mzvic/Piezopulse/20250524PruebaSchussler/Spectacular Allis.stl

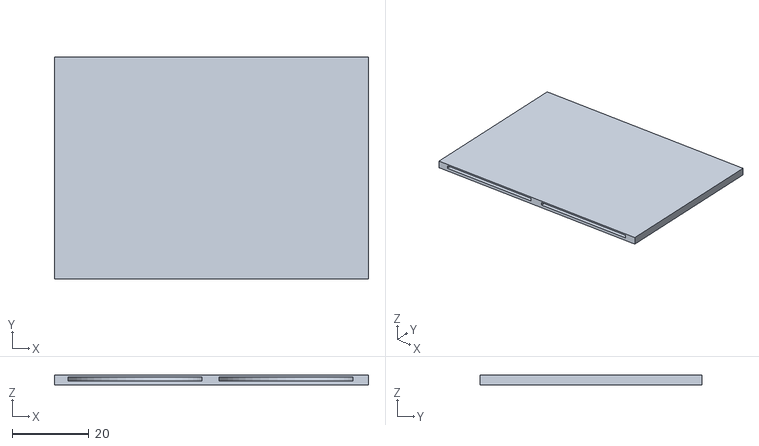
[picture p1: CAD file, 2025-06-02]
20250524PruebaSchussler/Spectacular Allis.stl
82.0 x 58.0 x 2.50
