mzvic/Piezopulse/20250608PruebaBasquetUdec/carcasa.stl

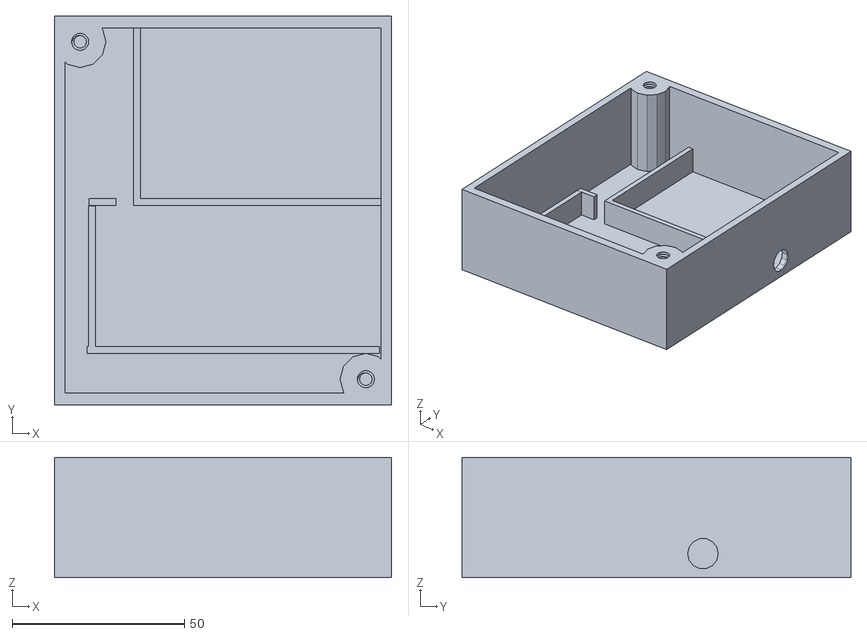
[picture p2: CAD file, 2025-06-09]
20250608PruebaBasquetUdec/carcasa.stl
98.0 x 113.0 x 35.0
