mzvic/Piezopulse/20250524PruebaSchussler/tex/main.pdf

# Reporte Pruebas Piezopulse en Schussler S.A. 24/05

Isabel Fuentes
Vicente Montesinos

19 de junio de 2025

## Índice

1. Contextualización | 2
2. Configuración Experimental | 3
3. Resultados y Análisis | 5
4. Conclusión y próximos pasos | 8

## 1. Contextualización

Piezopulse es un proyecto innovador que busca aprovechar las vibraciones mecánicas generadas por maquinaria industrial y transformarlas en energía eléctrica almacenable. Mediante tecnología de piezoelectricidad, estas vibraciones se convierten en electricidad, la cual se almacena en baterías para su posterior uso. De esta manera, las empresas pueden optimizar su consumo energético, reducir costos y promover prácticas más sostenibles al reutilizar energía que normalmente se perdería.
Actualmente, se encuentra en la fase de evaluación de sistemas de captación, con el objetivo de maximizar la eficiencia de conversión y minimizar las pérdidas.
Como parte de esta fase, se realizaron pruebas en Schussler S.A., enfocadas en un equipo de su operación: una impresora flexográfica, específicamente en la sección de ventiladores. Se seleccionó esta máquina debido que es la que está constantemente en funcionamiento sin interrupciones. Para caracterizar el comportamiento mecánico del sistema, se midieron las vibraciones de la máquina utilizando un acelerómetro, lo que permitió cuantificar la amplitud y frecuencia de las oscilaciones. En paralelo, se registró el voltaje generado por los elementos piezoeléctricos bajo estas condiciones operativas, estableciendo una relación directa entre el movimiento mecánico y la energía eléctrica recuperable.


Figura 1: Sistema puesto en terreno

## 2. Configuración Experimental

El prototipo desarrollado para las pruebas en Schussler S.A. incorporó los siguientes componentes clave, configurados de la siguiente manera:

### 2.1. Captación de Energía

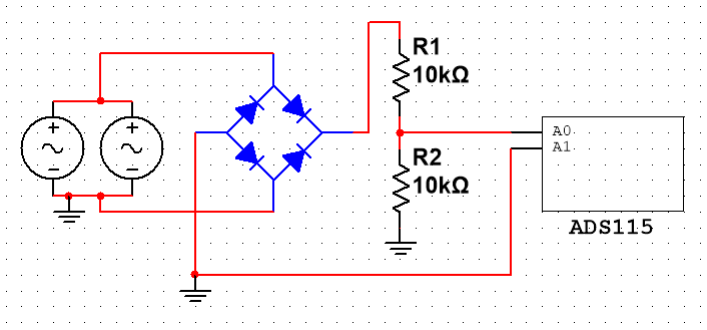
[picture p10: figure]

Figura 2: Esquema del sistema piezoeléctrico (Representados con una fuente alterna)

El sistema de captación de energía consiste en dos elementos piezoeléctricos de 35mm conectados en paralelo, una disposición que permite maximizar la corriente de salida en respuesta a las vibraciones mecánicas. La señal alterna generada por los piezos se convierte a corriente continua mediante un puente rectificador Schottky, seleccionado específicamente para minimizar las pérdidas por caída de voltaje en el proceso de rectificación. Para garantizar la seguridad del sistema de medición, se implementó un divisor resistivo de 10kΩ que asegura que el voltaje no exceda los 5V, límite máximo de entrada del conversor analógico-digital ADS1115, protegiendo así el circuito de adquisición de datos contra posibles picos de voltaje.

Con diodos estándar (1N4007): VF ≈ 0,7V ⇒ Vpérdida = 1,4V Con Schottky (1N5817): VF ≈ 0,3V ⇒ Vpérdida = 0,6V

Donde VF es la caída de voltaje directo en cada diodo.

Para la correcta integración de la captación de energía, se desarrolló un modelo 3D para alojar los dos piezoeléctricos. Este diseño comprende dos capas de material: una primera capa de 0.5 mm de espesor diseñada para estar en contacto directo con la máquina, facilitando la transferencia de vibraciones. Superpuesta a esta, se encuentra una segunda capa de 1 mm de espesor. En el interior de estas capas, se incorporó un hueco de 1 mm de profundidad diseñado con precisión para permitir la ubicación óptima de los piezoeléctricos de 35 mm de diámetro, asegurando su estabilidad y el correcto acoplamiento mecánico para una eficiente recolección de energía.


Figura 3: Modelo con piezoeléctrico

### 2.2. Medición y Adquisición de Datos

El sistema incorpora un acelerómetro MPU6050 que registra con precisión las vibraciones de la impresora flexográfica a lo largo de los tres ejes espaciales (X, Y y Z). Complementando este subsensor, se emplea un convertidor analógico-digital ADS1115 configurado en modo diferencial, donde la entrada positiva (A0) recibe la señal de los piezos rectificados y la entrada negativa (A1) se conecta a tierra como referencia, ofreciendo una lectura precisa del voltaje rectificado proveniente de los elementos piezoeléctricos con una resolución de 16 bits para las mediciones eléctricas. Esta configuración diferencial permite eliminar el ruido común y mejorar la precisión de las mediciones en el entorno industrial. Un microcontrolador Arduino Uno centraliza el procesamiento, recibiendo y almacenando los datos provenientes tanto del MPU6050 como del ADS1115.

### 2.3. Procesamiento y Almacenamiento

El subsistema de procesamiento y almacenamiento, implementado mediante un código Arduino[1], opera en tiempo real registrando simultáneamente los datos de vibración captados por el acelerómetro MPU6050 y las mediciones de voltaje obtenidas del circuito piezoeléctrico a través del ADC ADS1115.

Figura 4: Sistema General

## 3. Resultados y Análisis

### 3.1. Caracterización de la Vibración

### 3.1.1. Estadística generales por eje

El acelerómetro tri-axial (MPU6050) instalado en la impresora flexográfica proporcionó información en las componentes AccelX, AccelY y AccelZ, en unidades de m/s²
:
| Mínimo | Máximo | Media | Desviación Estándar
AccelX | -10.52 | -8.18 | -9.36 | 0.325
AccelY | -2.38 | 3.77 | 0.642 | 0.187
AccelZ | -3.03 | 0.280 | -1.41 | 0.385

Eje X (AccelX): La media cercana a -9.8 m/s² indica que este eje está alineado con la dirección de la gravedad. La desviación estándar baja (0.32 m/s²
| | | | ) sugiere que las vibraciones en este eje
son mínimas o casi inexistentes. La máquina permanece estable en este eje.

Eje Y (AccelY): La aceleración promedio es de 0.64 m/s²
| | | | , con una desviación moderada (0.19
m/s²

), lo que indica presencia de vibración ligera. El rango desde -2.38 a 3.77 m/s² muestra que existen picos en ambos sentidos, lo que sugiere oscilaciones transversales posiblemente inducidas por el funcionamiento de la máquina.

Eje Z (AccelZ): Este eje muestra una aceleración promedio negativa (-1.41 m/s²
) con la mayor
desviación estándar de los tres (0.38 m/s²

), y un rango significativo (-3.03 a 0.28 m/s² ). Esto
indica que el eje Z es el más afectado por las vibraciones de la máquina, probablemente en la dirección vertical u otra perpendicular al plano principal del equipo.

En resumen, el eje más vibrante es el Z, seguido del Y, mientras que el X está dominado por la gravedad (poca vibración útil).

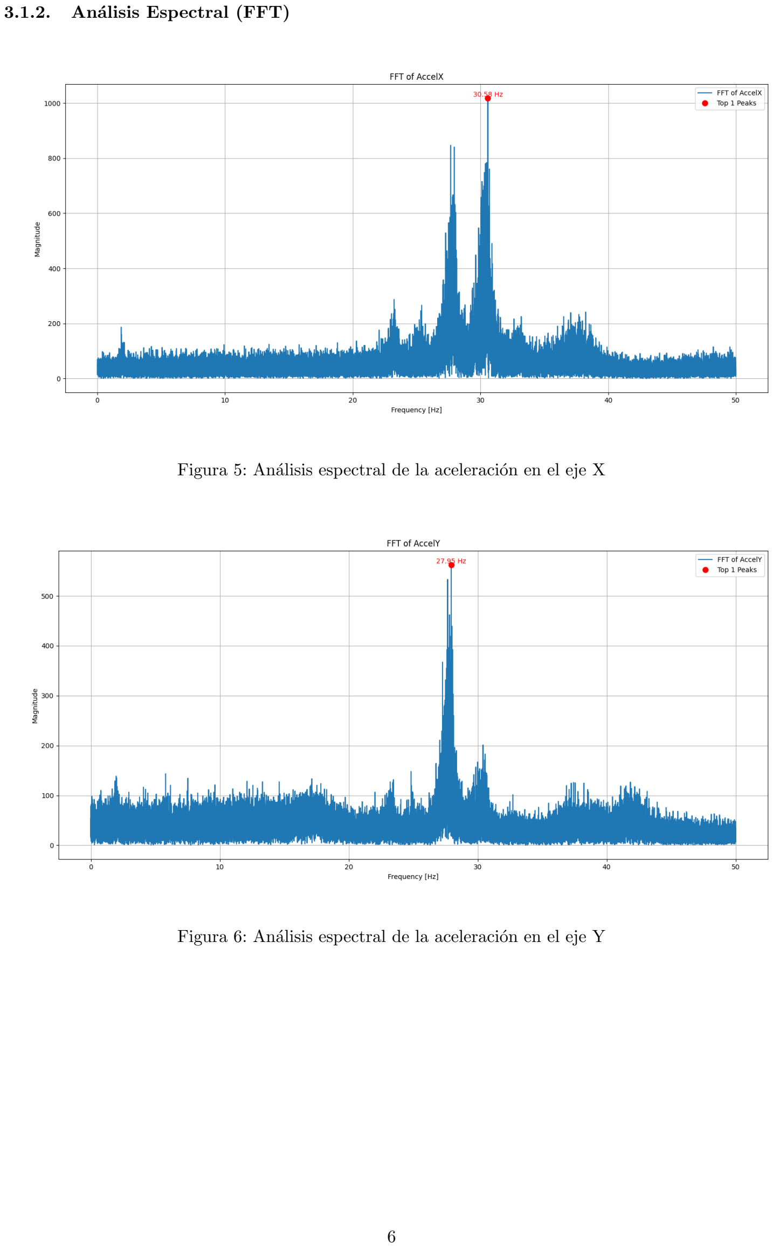
[picture p11: page 6]

### 3.1.2. Análisis Espectral (FFT)

Figura 5: Análisis espectral de la aceleración en el eje X

Figura 6: Análisis espectral de la aceleración en el eje Y


Figura 7: Análisis espectral de la aceleración en el eje Z

Se aplicó una transformada rápida de Fourier (FFT) a las señales de aceleración en los tres ejes (AccelX, AccelY, AccelZ) para identificar las componentes de frecuencia presentes durante el funcionamiento de la impresora flexográfica. Se observó un pico dominante de amplitud en torno a los 30 Hz en los tres ejes. Esta frecuencia es relevante para el proyecto, ya que si el sistema piezoeléctrico tiene una frecuencia de resonancia cercana a 30 Hz, se maximiza la eficiencia de conversión energética.

### 3.2. Energía piezoeléctrica

Durante la operación de la máquina, se registró el voltaje generado por un conjunto de piezoeléctricos conectados en paralelo, acoplados mecánicamente a su estructura. La señal fue rectificada y atenuada mediante una divisora resistiva (2 resistencias de 10kΩ) antes de ser medida por un conversor ADS1115 en modo diferencial.

| Mínimo | Máximo | Media | Desviación Estándar
Voltaje | 0.00 | 10.10 | 0.664 | 0.653

Cuadro 1: Estadísticas del voltaje producido por los piezoeléctricos (en milivolts)

Aunque los niveles de voltaje son bajos, se confirma que los piezoeléctricos generan señal eléctrica a partir de las vibraciones reales de la máquina. La aparición de voltajes máximos cercanos a 10mV demuestra que en ciertas condiciones, posiblemente a picos de vibración, el sistema puede captar energía de forma significativa. La media baja indica que el sistema no opera continuamente en esas condiciones óptimas, lo que es esperable dado que el acoplamiento no está sintonizado aún para 30 Hz.
En conclusión, el sistema es capaz de convertir vibraciones mecánicas reales en energía eléctrica, incluso en condiciones no óptimas y la señal generada puede ser utilizada como fuente de energía si se incorpora un sistema de acumulación y regulación.

### 3.3. Relación entre vibración y generación

Ya que se observó que el eje más vibrante es el Z, haremos la comparación entre el voltaje generado por los piezoeléctricos y la vibración en el eje Z.


Figura 8: Extracto de las muestras obtenidas.

Se encontraron 13331 puntos donde ambos valores aumentan al mismo tiempo, estos puntos se muestran reflejados en verde en el gráfico. Se evidencian coincidencias temporales entre los picos de aceleración y los aumentos de voltaje. Esto confirma que el sistema piezoeléctrico responde de forma efectiva a la vibración mecánica, transformando parte de la energía cinética en voltaje utilizable.

## 4. Conclusión y próximos pasos

La prueba realizada sobre una impresora flexográfica permitió validar el concepto fundamental del sistema PiezoPulse: convertir vibraciones mecánicas reales en energía eléctrica utilizable mediante piezoeléctricos. Los principales hallazgos son:

Se observó una frecuencia dominante de vibración en 30 Hz, presente en los tres ejes del acelerómetro, lo que indica una oscilación estructural importante en la máquina.

El eje Z mostró la mayor variabilidad, coincidiendo con la mayor actividad vibracional y con los momentos de mayor voltaje generado por los piezoeléctricos.

El voltaje piezoeléctrico alcanzó valores de hasta 10.1mV, con una media de 0.66mV, demostrando la capacidad del sistema para captar energía real desde el entorno.

En conjunto, los resultados respaldan la viabilidad del enfoque PiezoPulse y permiten avanzar hacia una implementación práctica.
Para escalar y mejorar el sistema, se proponen las siguientes acciones:

Probar con diferentes conexiones de piezoeléctricos (paralelo o serie) y escalar el número de piezoeléctricos ocupados

Utilizar piezoeléctricos con una frecuencia de resonancia más cercana a los 30 Hz observados o evaluar otras estructuras mecánicas resonantes.

Integrar un sistema con diodos Schottky + supercondensador o batería Li-ion para acumular la energía generada.

## Referencias

[1] A. M. Z. Vicente, “Piezopulse Data,” GitHub repository, 2025. [Online]. Available: https://github.com/mzvic/Piezopulse. Commit: 139a056b413fea6309fc6aff419420ad5c2312db
