mzvic/Piezopulse/20250608PruebaBasquetUdec/tex/Reporte_Pruebas_Piezopulse_en_Casa_del_Deporte_08_06-1.pdf

# Reporte Pruebas Piezopulse en Casa del Deporte 08/06

Isabel Fuentes
Vicente Montesinos

28 de agosto de 2025

## Índice

1. Contextualización | 2
2. Configuración Experimental | 3
3. Resultados y Análisis | 4
4. Aplicación del sistema y enfoque sostenible | 5
5. Conclusión y próximos pasos | 6

## 1. Contextualización

Piezopulse es una tecnología innovadora diseñada para transformar las vibraciones mecánicas generadas por maquinaria industrial en energía eléctrica almacenable, con el objetivo de reutilizarla dentro del mismo entorno productivo. Este enfoque permite a las empresas mejorar su eficiencia energética, reducir costos operativos y alinearse con políticas de sostenibilidad, disminuyendo el desperdicio energético inherente a sus procesos.

Actualmente, el desarrollo se encuentra en una fase de evaluación de sistemas de captación y optimización estructural del sistema, con el objetivo de maximizar la eficiencia de conversión y definir una configuración física y eléctrica óptima del sistema.

En una primera instancia, se realizaron pruebas en Schussler S.A[1], utilizando como objeto de estudio una impresora flexográfica. La cual forma parte del equipo operativo de la empresa y destaca por encontrarse en constante funcionamiento. Estas pruebas permitieron caracterizar las vibraciones del equipo y correlacionarlas con la energía eléctrica recuperable mediante el sistema.

Como parte de la expansión de escenarios de prueba, se llevó a cabo una medición en un entorno no industrial: un evento deportivo de alta concurrencia realizado en la Casa del Deporte de la Universidad de Concepción, durante un partido de básquetbol con asistencia masiva de público. Esta instancia permitió explorar el comportamiento del sistema frente a vibraciones de baja frecuencia e intensidad variable, producidas tanto por el movimiento del público como por la presión acústica del ambiente.

El sistema fue ubicado sobre una galería habilitada para los espectadores, con cuatro elementos piezoeléctricos adheridos en su cara inferior, en contacto directo con la estructura. Se evaluaron dos configuraciones eléctricas (paralelo y serie) con el objetivo de comparar el voltaje generado bajo cada disposición. Estas pruebas permiten enriquecer la caracterización del sistema en contextos dinámicos y no controlados, aportando datos valiosos para futuras aplicaciones en entornos industriales complejos o con fuentes de vibración irregulares.


Figura 1: Sistema en el sitio de pruebas

## 2. Configuración Experimental

El prototipo desarrollado para las pruebas realizadas durante el partido de básquetbol incorporó los siguientes componentes clave, organizados de la siguiente manera:

### 2.1. Captación de energía

El sistema de captación de energía está compuesto por elementos piezoeléctricos de 35 mm de diámetro. Inicialmente, se utilizaron dos de estos piezoeléctricos, probando dos configuraciones distintas: en paralelo, para maximizar la corriente de salida, y en serie, con el objetivo de aumentar el voltaje generado.

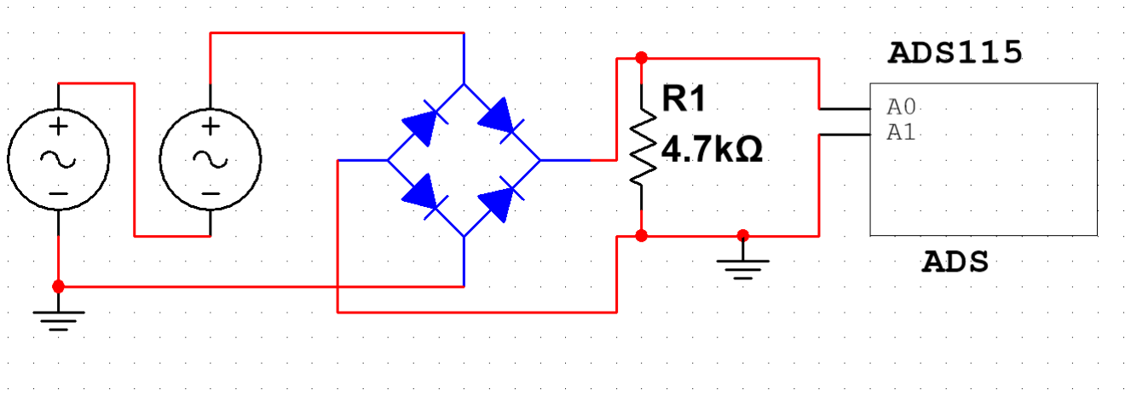
[picture p17: figure]

Figura 2: Piezoeléctricos en paralelo | Figura 3: Piezoeléctricos en serie

Para asegurar una correcta transferencia de las vibraciones hacia los piezoeléctricos, se reutilizó el modelo 3D previamente diseñado para las pruebas en Schussler, el cual, gracias a sus caras de espesor mínimo, facilita la transmisión eficiente de vibraciones[1].

Adicionalmente, se diseñó una segunda estructura 3D para alojar la protoboard y el microcontrolador Arduino, lo que simplificó el transporte y brindó mayor estabilidad a las conexiones electrónicas. Ambos módulos fueron unidos mediante cinta metálica tipo foil tape, lo que permitió optimizar el espacio y reducir el riesgo de desprendimiento durante las pruebas.


Figura 4: Estructura del sistema electrónico

### 2.2. Medición y Adquisición de datos

El sistema incorpora un conversor analógico-digital ADS1115 configurado en modo diferencial. La entrada positiva A0 se conectó al extremo positivo de una resistencia de 4.97 kΩ, mientras que la entrada negativa A1 se conectó al extremo negativo de la misma resistencia. Esta configuración permitió medir la caída de voltaje directamente a través de la resistencia, aprovechando la alta resolución de 16 bits del ADS1115 para obtener lecturas precisas. El procesamiento y almacenamiento de los datos adquiridos desde el ADS1115 fueron gestionados por un microcontrolador Arduino Uno que centralizó el funcionamiento del sistema de medición. [2]

## 3. Resultados y Análisis

### 3.1. Energía piezoeléctrica

Durante el partido de básquetbol, se registró el voltaje generado por dos piezoeléctricos conectados en paralelo, los cuales fueron ubicados sobre una grada destinada al público. La señal generada fue medida a través de una resistencia de 4.97kΩ, permitiendo estimar la corriente inducida por las vibraciones del entorno.

| Mínimo | Máximo | Media
Voltaje (mV) | 32.3 | 47.3 | 41.2
Corriente (µA) | 6.50 | 9.52 | 8.29

Cuadro 1: Resumen estadístico del voltaje y corriente con piezoeléctricos ubicados en paralelo.

Si bien los niveles de voltaje y corriente obtenidos con solo dos piezoeléctricos son bajos y no permiten, por sí solos, alimentar dispositivos electrónicos de forma directa, los resultados confirman que es posible extraer energía a partir de vibraciones en este tipo de entornos. La consistencia de los valores registrados —sin grandes variaciones pese a la naturaleza dinámica del ambiente— sugiere que el sistema es estable y repetible. Esto refuerza la viabilidad de escalar el sistema: al aumentar la cantidad de piezoeléctricos , optimizar el almacenamiento y acondicionamiento de la señal se podría lograr una captación de energía significativa y útil en aplicaciones reales dentro de espacios con actividad constante, como instalaciones deportivas.

Después de un tiempo utilizando el sistema con los piezoeléctricos conectados en paralelo, se modificó su configuración para conectarlos en serie, manteniéndose las mismas condiciones de medición mediante una resistencia de 4.97kΩ.

| Mínimo | Máximo | Media
Voltaje (mV) | 0.2 | 12.2 | 3.40
Corriente (µA) | 0.04 | 2.46 | 0.68

Cuadro 2: Resumen estadístico del voltaje y corriente con piezoeléctricos ubicados en serie.

Al igual que en la configuración paralela, los resultados muestran que los piezoeléctricos continúan generando señal eléctrica ante las perturbaciones del entorno, a pesar de los bajos niveles de voltaje y corriente. La variación observada en los valores es acotada, lo cual indica una respuesta estable del sistema frente a esta nueva disposición.

De los resultados obtenidos se deduce que, contrario a lo que indica la teoría básica (donde una conexión en serie debería aumentar el voltaje total) en la práctica esto no se reflejó debido a que las señales generadas por los piezoeléctricos tienden a cancelarse entre sí cuando están en serie. Por otro lado, la configuración en paralelo no presenta esta limitación, lo que representa una ventaja significativa, ya que además del voltaje estable, se observa un aumento en la corriente total generada.
Aún utilizando una cantidad reducida de piezoeléctricos y bajo condiciones estructurales no optimizadas para la transmisión de vibraciones, es posible generar energía eléctrica aprovechable a partir de las vibraciones en ambientes como gradas deportivas. Con un diseño escalable este tipo de tecnología podría ser implementada para alimentar dispositivos o sistemas auxiliares en espacios deportivos y otros entornos con actividad constante y vibraciones repetitivas.

Considerando los voltajes de ambas disposiciones durante el muestreo se obtienen los siguientes gráficos:


Figura 5: Voltajes obtenidos para ambas disposiciones durante el muestreo.

## 4. Aplicación del sistema y enfoque sostenible

Posterior al análisis realizado a las mediciones obtenidas y la consideración de las características del medio en que fué realizado el testeo, la tecnología presentada presenta las condiciones aptas para exponerse en entornos sociales donde la participación de los espectadores corresponde a la fuente de vibraciones mecánicas captadas. Considerando posteriores optimizaciones del sistema para mayor recepción y un mantenimiento de la estructura posibilitando su transporte y ubicación, el carácter de sostenible se hace presente de forma relevante dentro de la descripción de la tecnología.
En la actualidad, la implementación de tecnologías que permiten limitar o cesar el uso de fuentes de energías no renovables o estándares y que, cumplen con cualidades como sustentabilidad y sostenibilidad, presentan gran relevancia y consideración en su implementación. La sostenibilidad por su parte, se describe como la capacidad de satisfacer las necesidades del presente sin comprometer la capacidad de las generaciones futuras para satisfacer sus propias necesidades; considerando las repercusiones sociales, medioambientales y económicas de las decisiones que se toman en la actualidad. Ante la problemática del uso de fuentes típicas de energía y sus consecuencias sociales, ambientales y productivas, proponer desarrollos tecnológicos que entreguen soluciones adecuadas a los requerimientos mencionados se presenta como importante.

La tecnología Piezopulse cumple con el carácter de sostenible, no modificando el ambiente en el que se aplica y aprovechando las condiciones de este mismo sin generar consecuencias. Es de esta forma que se presenta con grandes ventajas ante otros desarrollos tecnológicos similes, destacando por su fácil incorporación en los sitios u objetos que experimentan vibraciones sin alterar su funcionamiento y ocupando un espacio limitado en la estructura. Es de esta forma que Piezopulse en sus etapas incipientes se presenta con un potencial excepcional como fuente de energía verde, proyéctandose de forma alentadora para su aplicación en desarrollos posteriores mejorados y su futura implementación en el ambiente como fuente de energía verde.

## 5. Conclusión y próximos pasos

Las pruebas realizadas durante el partido de básquetbol en la casa del deporte UdeC permitieron validar el objetivo de funcionamiento y diseño de Piezopulse: transformar vibraciones presentes en entornos reales en energía eléctrica utilizable mediante piezoeléctricos. Como segundo testeo realizado en entorno real, se puede destacar:

Validación de la tecnología en entorno fuera del industrial, permitiendo ampliar su aplicación futura como solución tecnológica a espacios cotidianos donde existen vibraciones mecánicas.

Una distribución en paralelo de los piezoeléctricos permite rescatar más energia. Esto ocurre, debido a que, los piezoeléctricos al estar conectados en serie y a un sistema con vibraciones irregulares existe la posibilidad de que se cancelen mutuamente.

Como pasos a futuro con el fin de escalar el desarrollo de la tecnología y continuar con su validación en entornos reales, se propone:

Incorporación de más piezoeléctricos dispuestos en ambas conexiones

Integrar un sistema que permita acumular la energía generada

## Referencias

[1] Isabel Fuentes y Vicente Montesinos. Reporte Pruebas PiezoPulse en Schussler S.A. 24/05. https: / / github . com / mzvic / Piezopulse / blob / main / 20250524PruebaSchussler / tex / main . pdf. (https://github.com/mzvic/Piezopulse/blob/main/20250524PruebaSchussler/tex/main.pdf) PDF disponible en GitHub. 2025. (Visitado 19-06-2025).
[2] Vicente Montesinos. Código Arduino - Prueba Básquet UdeC. https : / / github . com / mzvic / Piezopulse / blob / main / 20250608PruebaBasquetUdec / arduino _ code / arduino _ code . ino. (https://github.com/mzvic/Piezopulse/blob/main/20250608PruebaBasquetUdec/arduino_code/arduino_code.ino) Código fuente disponible en GitHub. 2025. (Visitado 19-06-2025).
