mzvic/Piezopulse/20250608PruebaBasquetUdec/tex/comparacion voltajes.png

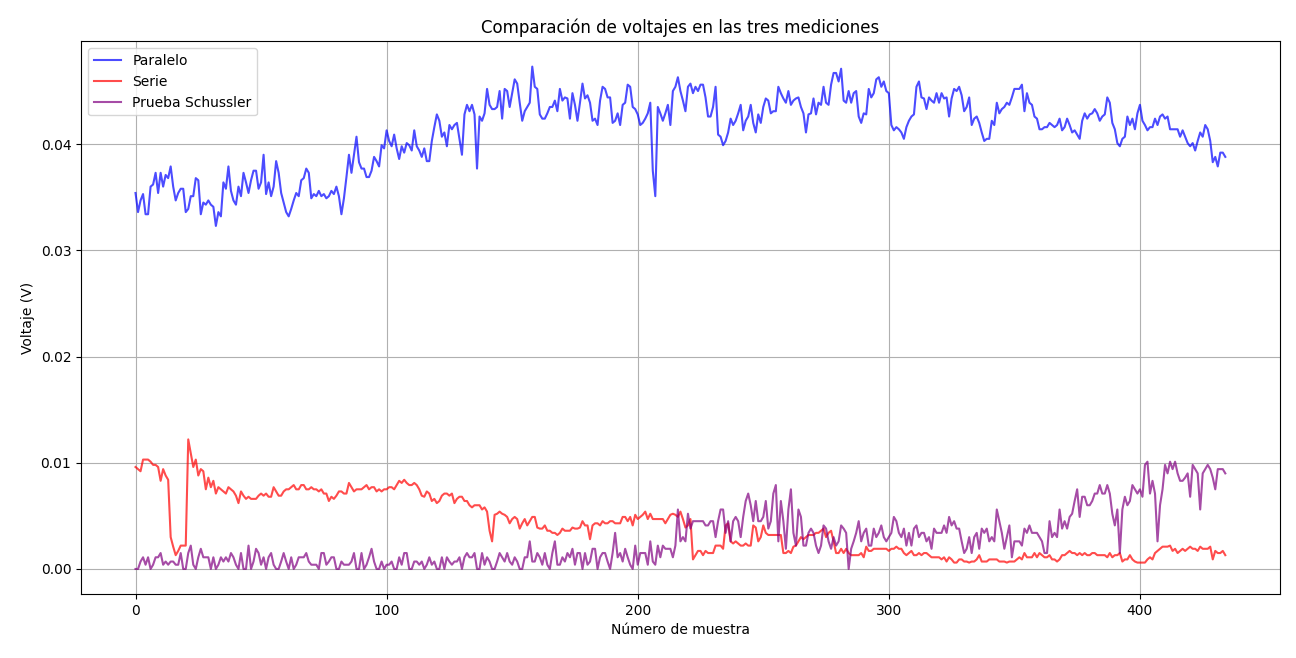
20250608PruebaBasquetUdec/tex/comparacion voltajes.png
