mzvic/Piezopulse/20250608PruebaBasquetUdec/tex/cambios de voltaje.png

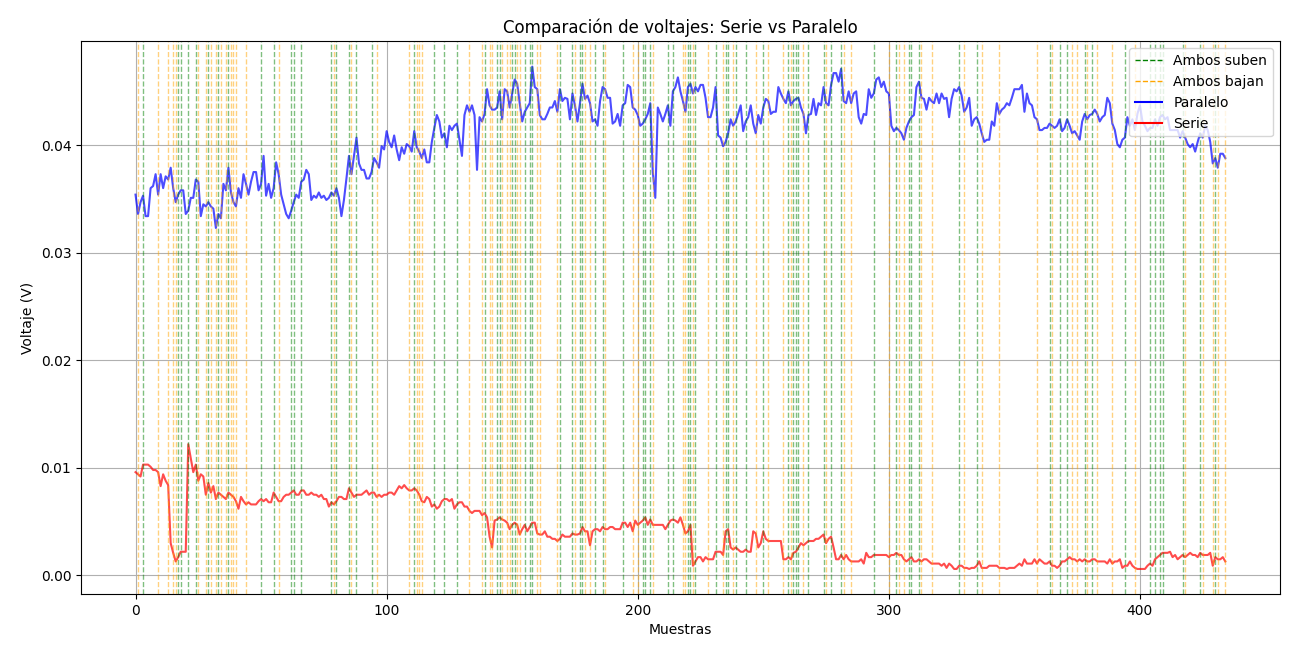
20250608PruebaBasquetUdec/tex/cambios de voltaje.png
