mzvic/Piezopulse/(commit log)

2025-06-02 Ordenando y recopilando archivos de primera prueba
    [Spectacular Allis.stl]
2025-06-09 archivos organizados para hacer el reporte
    [carcasa.stl]
